walger-lucas/SPARtS/docs/LatexFinal/BunnySuicidesLatex.png

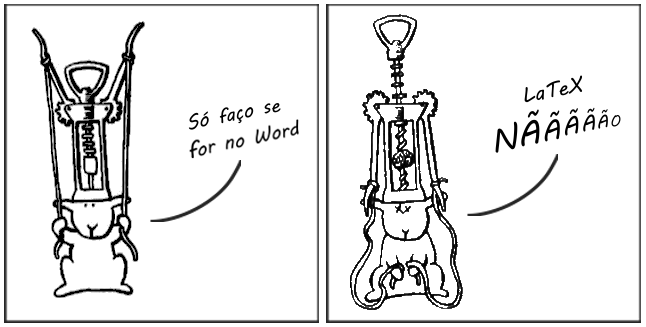
docs/LatexFinal/BunnySuicidesLatex.png
