walger-lucas/SPARtS/docs/LatexFinal/SistNumSeres_base2_3.png

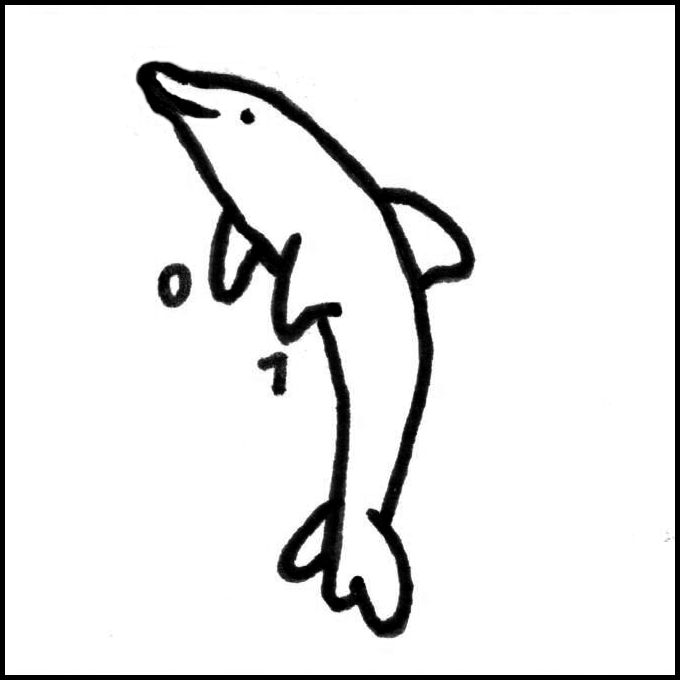
docs/LatexFinal/SistNumSeres_base2_3.png
