walger-lucas/SPARtS/docs/LatexFinal/SistNumSeres_base4_3.png

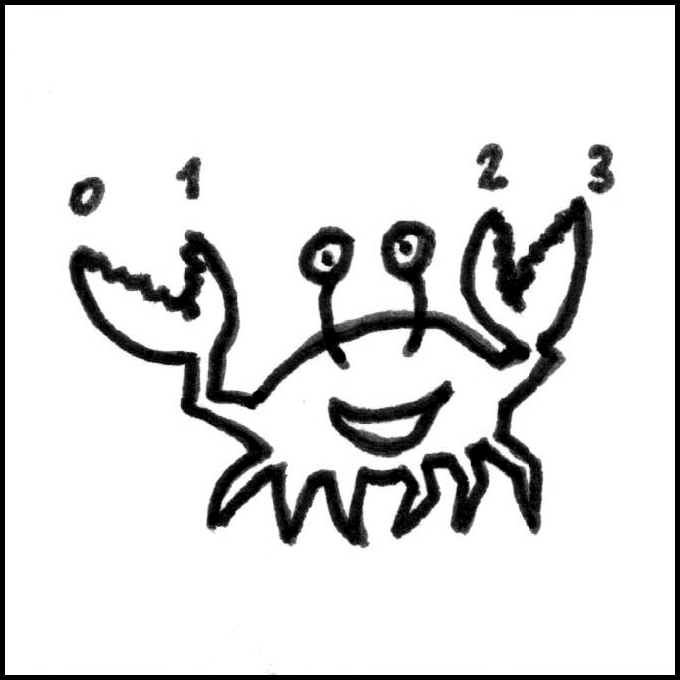
docs/LatexFinal/SistNumSeres_base4_3.png
