walger-lucas/SPARtS/docs/LatexFinal/SistNumSeres_base8_3.png

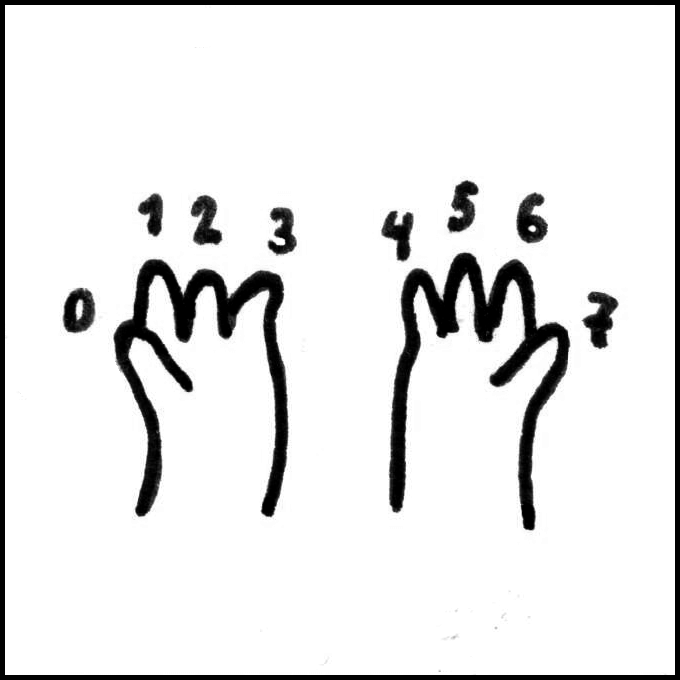
docs/LatexFinal/SistNumSeres_base8_3.png
