walger-lucas/SPARtS/docs/LatexFinal/SistNumSeres_base10_3.png

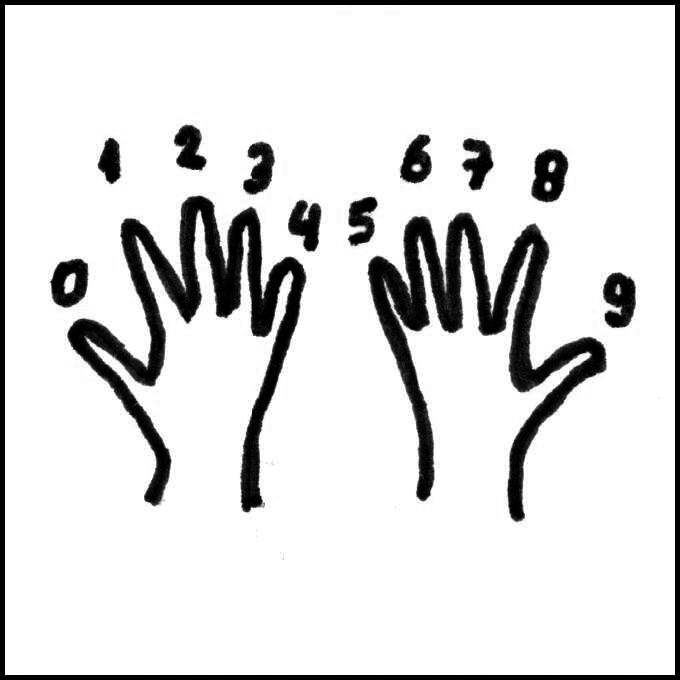
docs/LatexFinal/SistNumSeres_base10_3.png
