walger-lucas/SPARtS/docs/SoftwareDesign/class/class_diagram.png

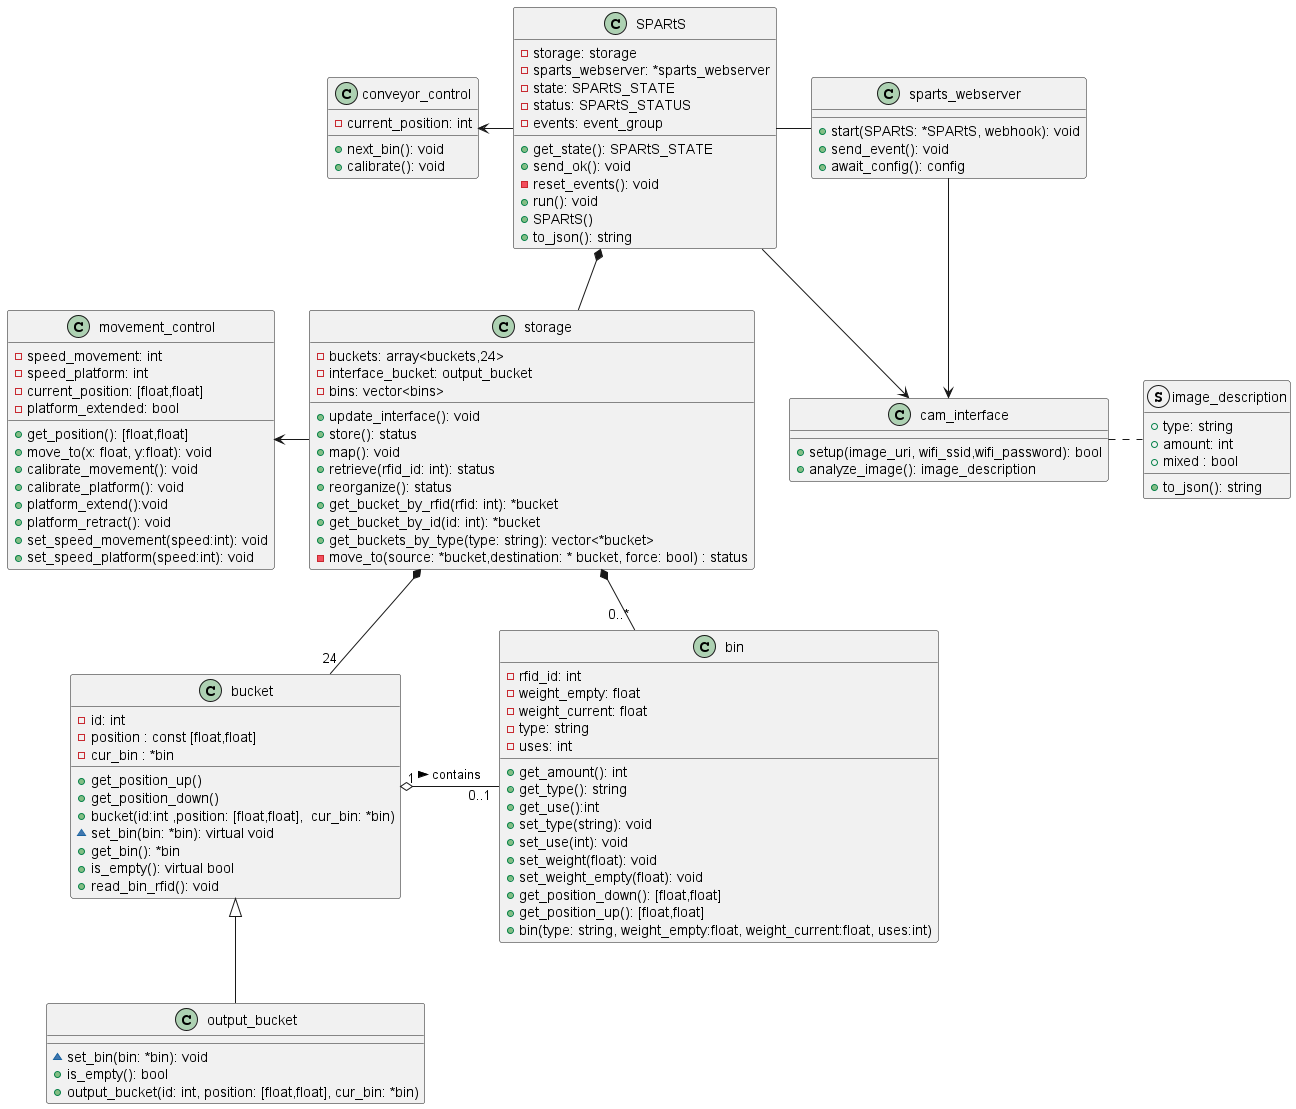
docs/SoftwareDesign/class/class_diagram.png
