walger-lucas/SPARtS/docs/SoftwareDesign/EmbeddedSoftware/output_diagrams/Await.png

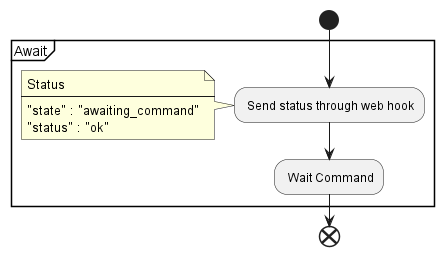
docs/SoftwareDesign/EmbeddedSoftware/output_diagrams/Await.png
