walger-lucas/SPARtS/docs/SoftwareDesign/EmbeddedSoftware/output_diagrams/EspCam.png

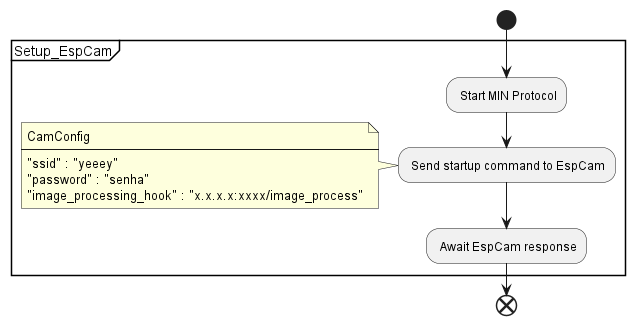
docs/SoftwareDesign/EmbeddedSoftware/output_diagrams/EspCam.png
