walger-lucas/SPARtS/docs/SoftwareDesign/EmbeddedSoftware/output_diagrams/fsm.png

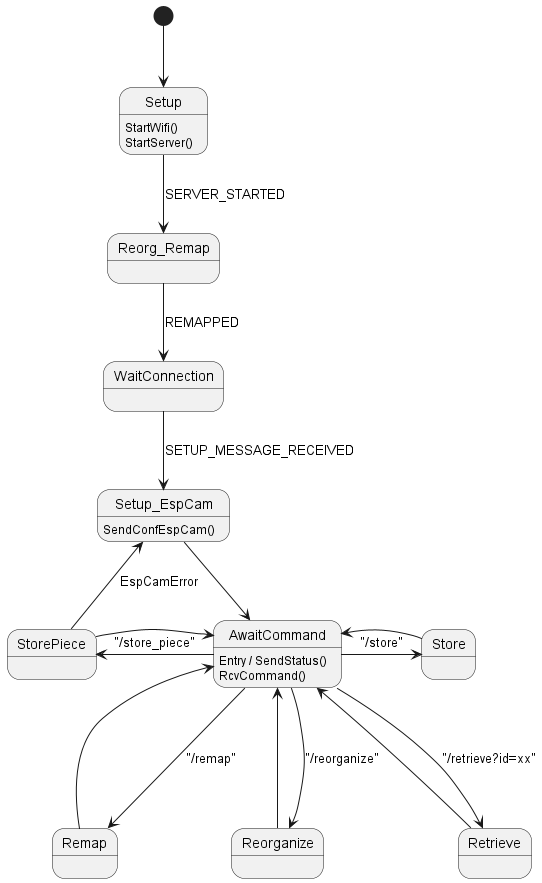
docs/SoftwareDesign/EmbeddedSoftware/output_diagrams/fsm.png
