walger-lucas/SPARtS/docs/SoftwareDesign/EmbeddedSoftware/output_diagrams/remap.png

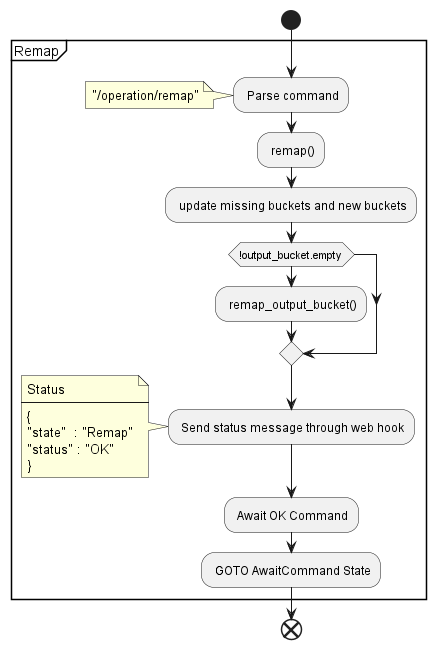
docs/SoftwareDesign/EmbeddedSoftware/output_diagrams/remap.png
