walger-lucas/SPARtS/docs/SoftwareDesign/EmbeddedSoftware/output_diagrams/Reorganize.png

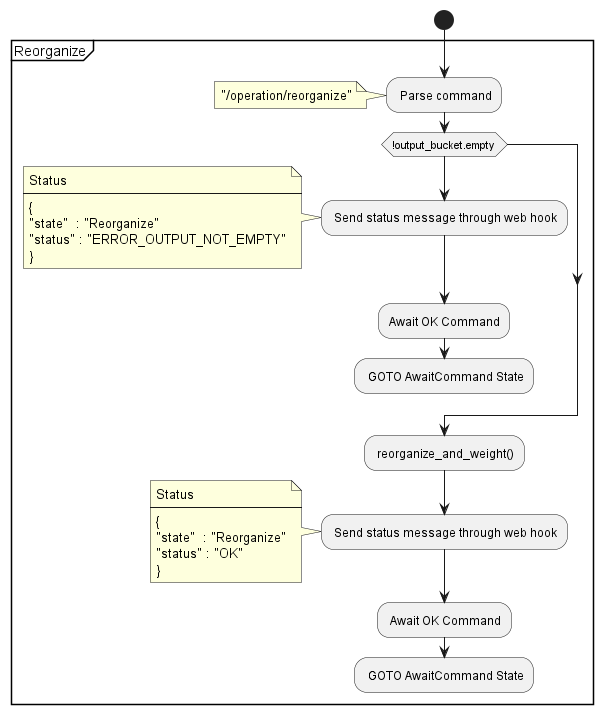
docs/SoftwareDesign/EmbeddedSoftware/output_diagrams/Reorganize.png
