walger-lucas/SPARtS/docs/SoftwareDesign/EmbeddedSoftware/output_diagrams/Retrieve.png

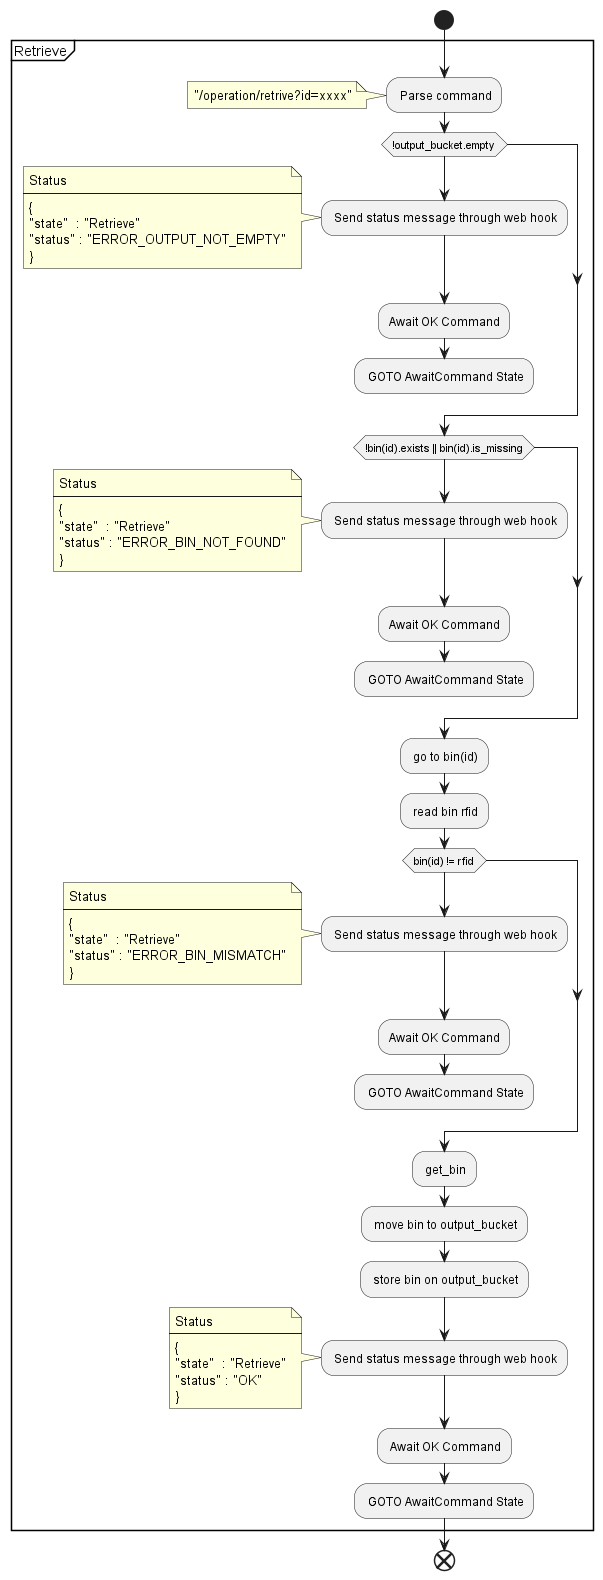
docs/SoftwareDesign/EmbeddedSoftware/output_diagrams/Retrieve.png
