walger-lucas/SPARtS/docs/SoftwareDesign/EmbeddedSoftware/output_diagrams/Store.png

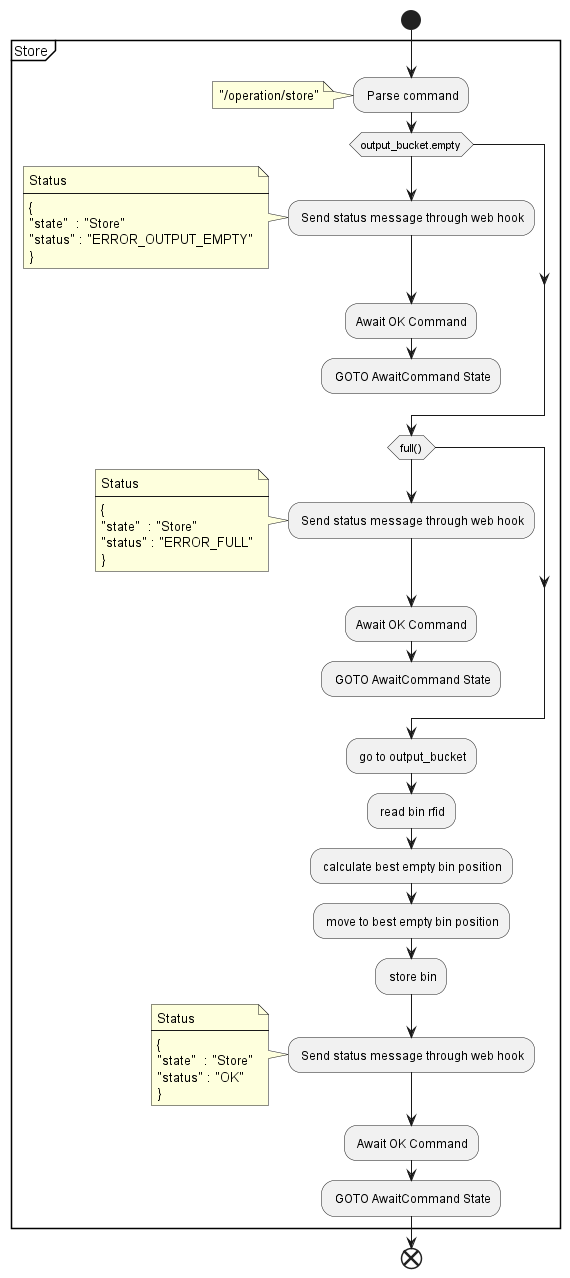
docs/SoftwareDesign/EmbeddedSoftware/output_diagrams/Store.png
