walger-lucas/SPARtS/docs/SoftwareDesign/EmbeddedSoftware/output_diagrams/Store_Piece.png

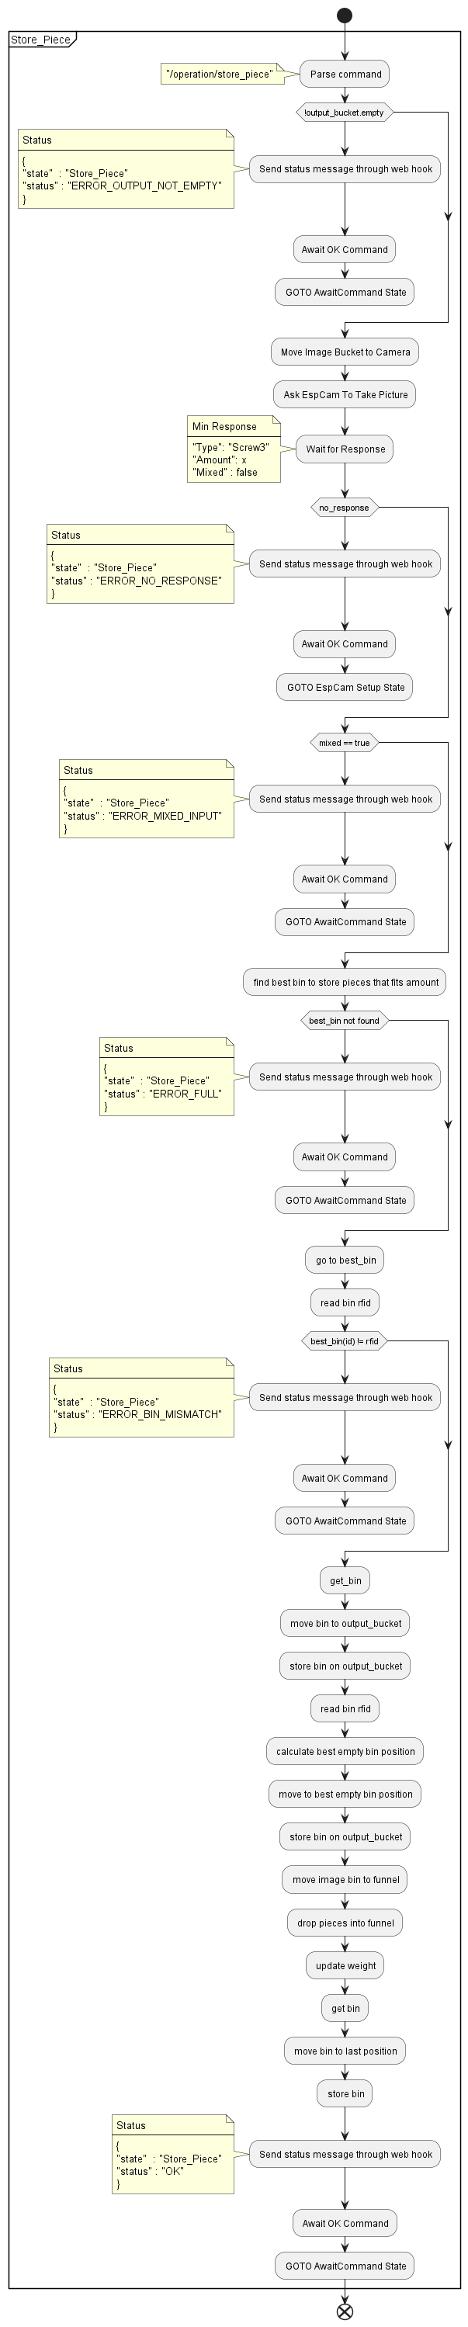
docs/SoftwareDesign/EmbeddedSoftware/output_diagrams/Store_Piece.png
