walger-lucas/SPARtS/docs/SoftwareDesign/flow.png

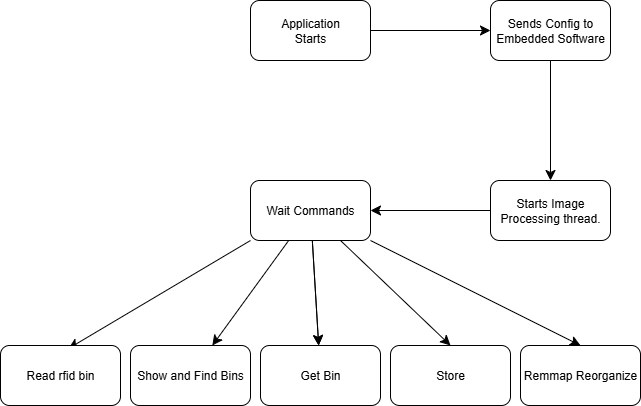
docs/SoftwareDesign/flow.png
