walger-lucas/SPARtS/docs/SoftwareDesign/EmbeddedSoftware/output_diagrams/SETUP.png

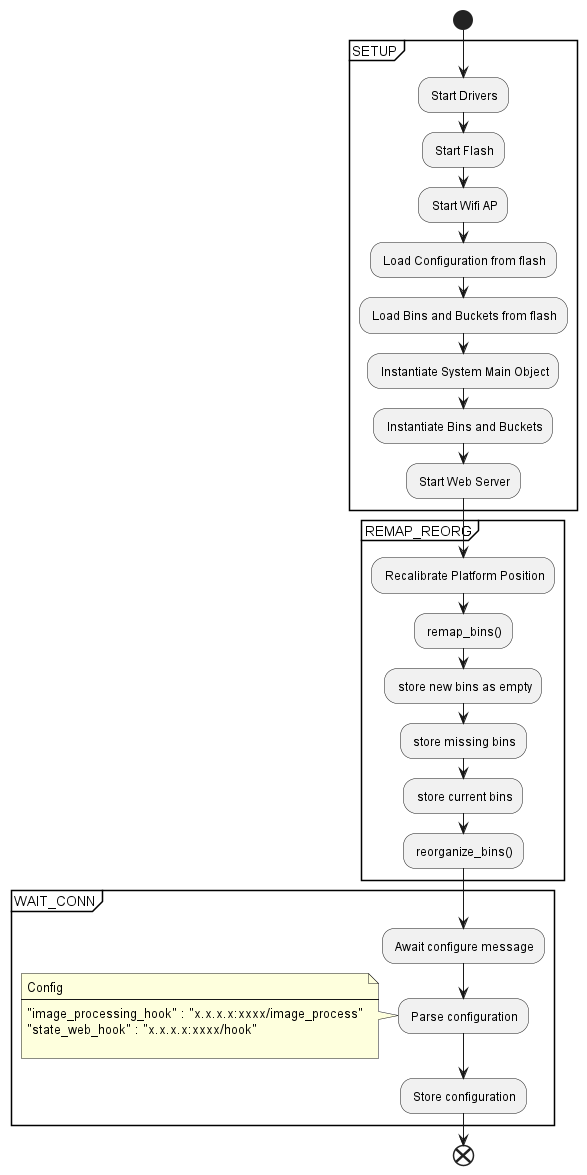
docs/SoftwareDesign/EmbeddedSoftware/output_diagrams/SETUP.png
