walger-lucas/SPARtS/docs/HardwareDesign/SPARtS.pdf

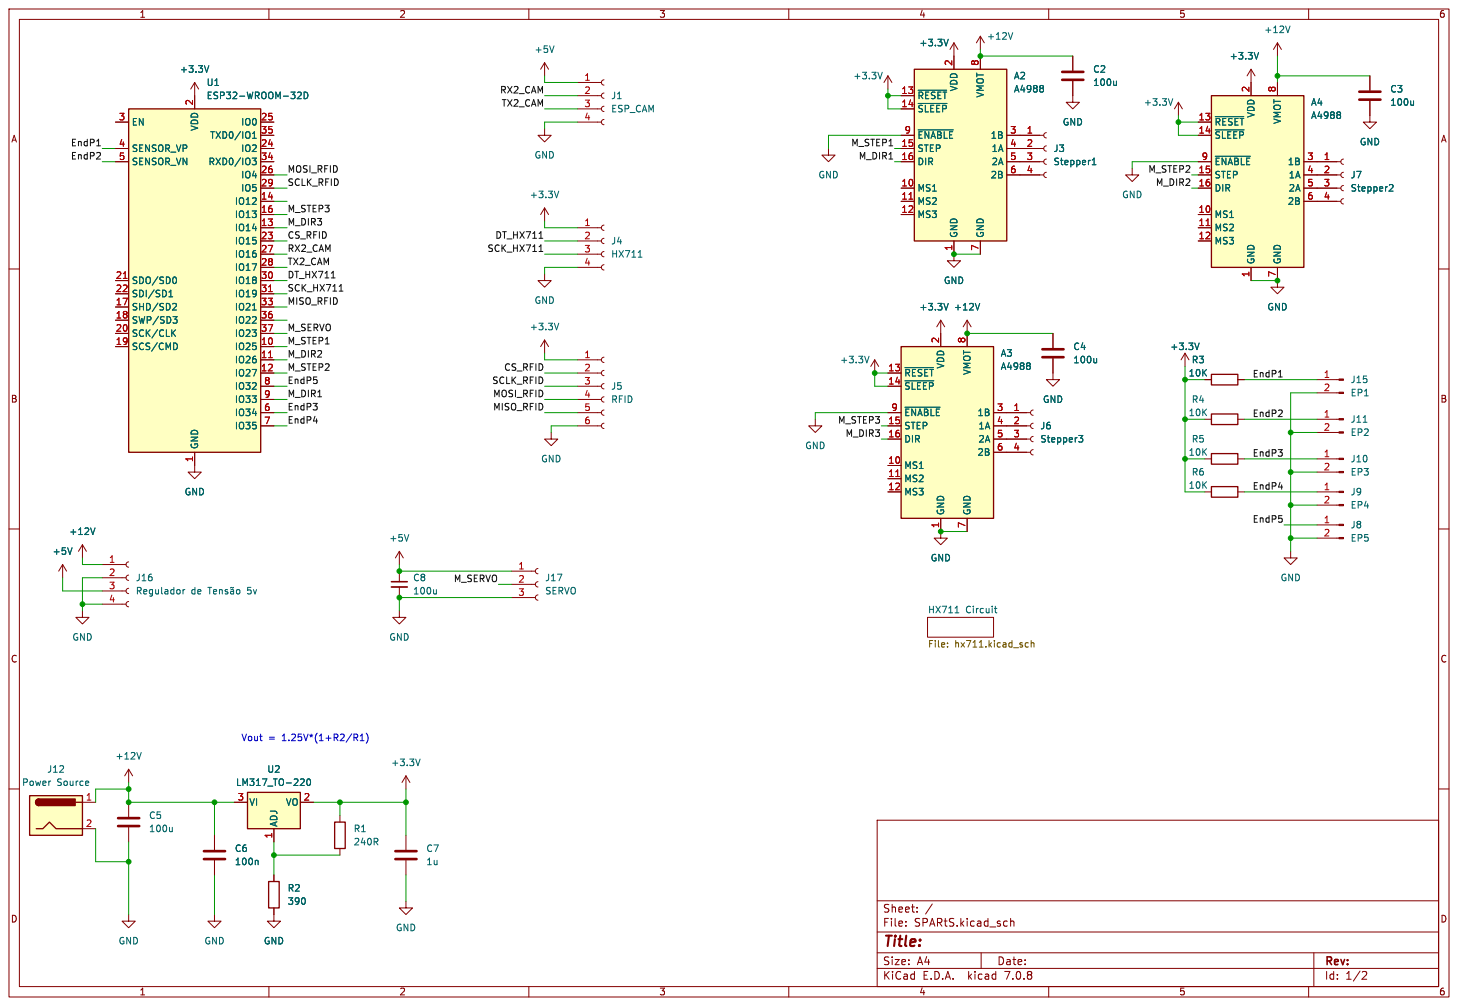
[picture p17: page 1]

1 MS1 10 MS2 11 MS3 12 ~{RESET} 13 ~{SLEEP} 14 STEP 15 DIR 16 VDD

2 SCK/CLK 20 SDO/SD0 21 SDI/SD1 22

Id: 1/2 Title: File: SPARtS.kicad_sch Sheet: /HX711 Circuit File: hx711.kicad_sch
