walger-lucas/SPARtS/docs/HardwareDesign/SPARtS.kicad_sch

## KiCad design docs/HardwareDesign/SPARtS.kicad_sch (2025-11-07)

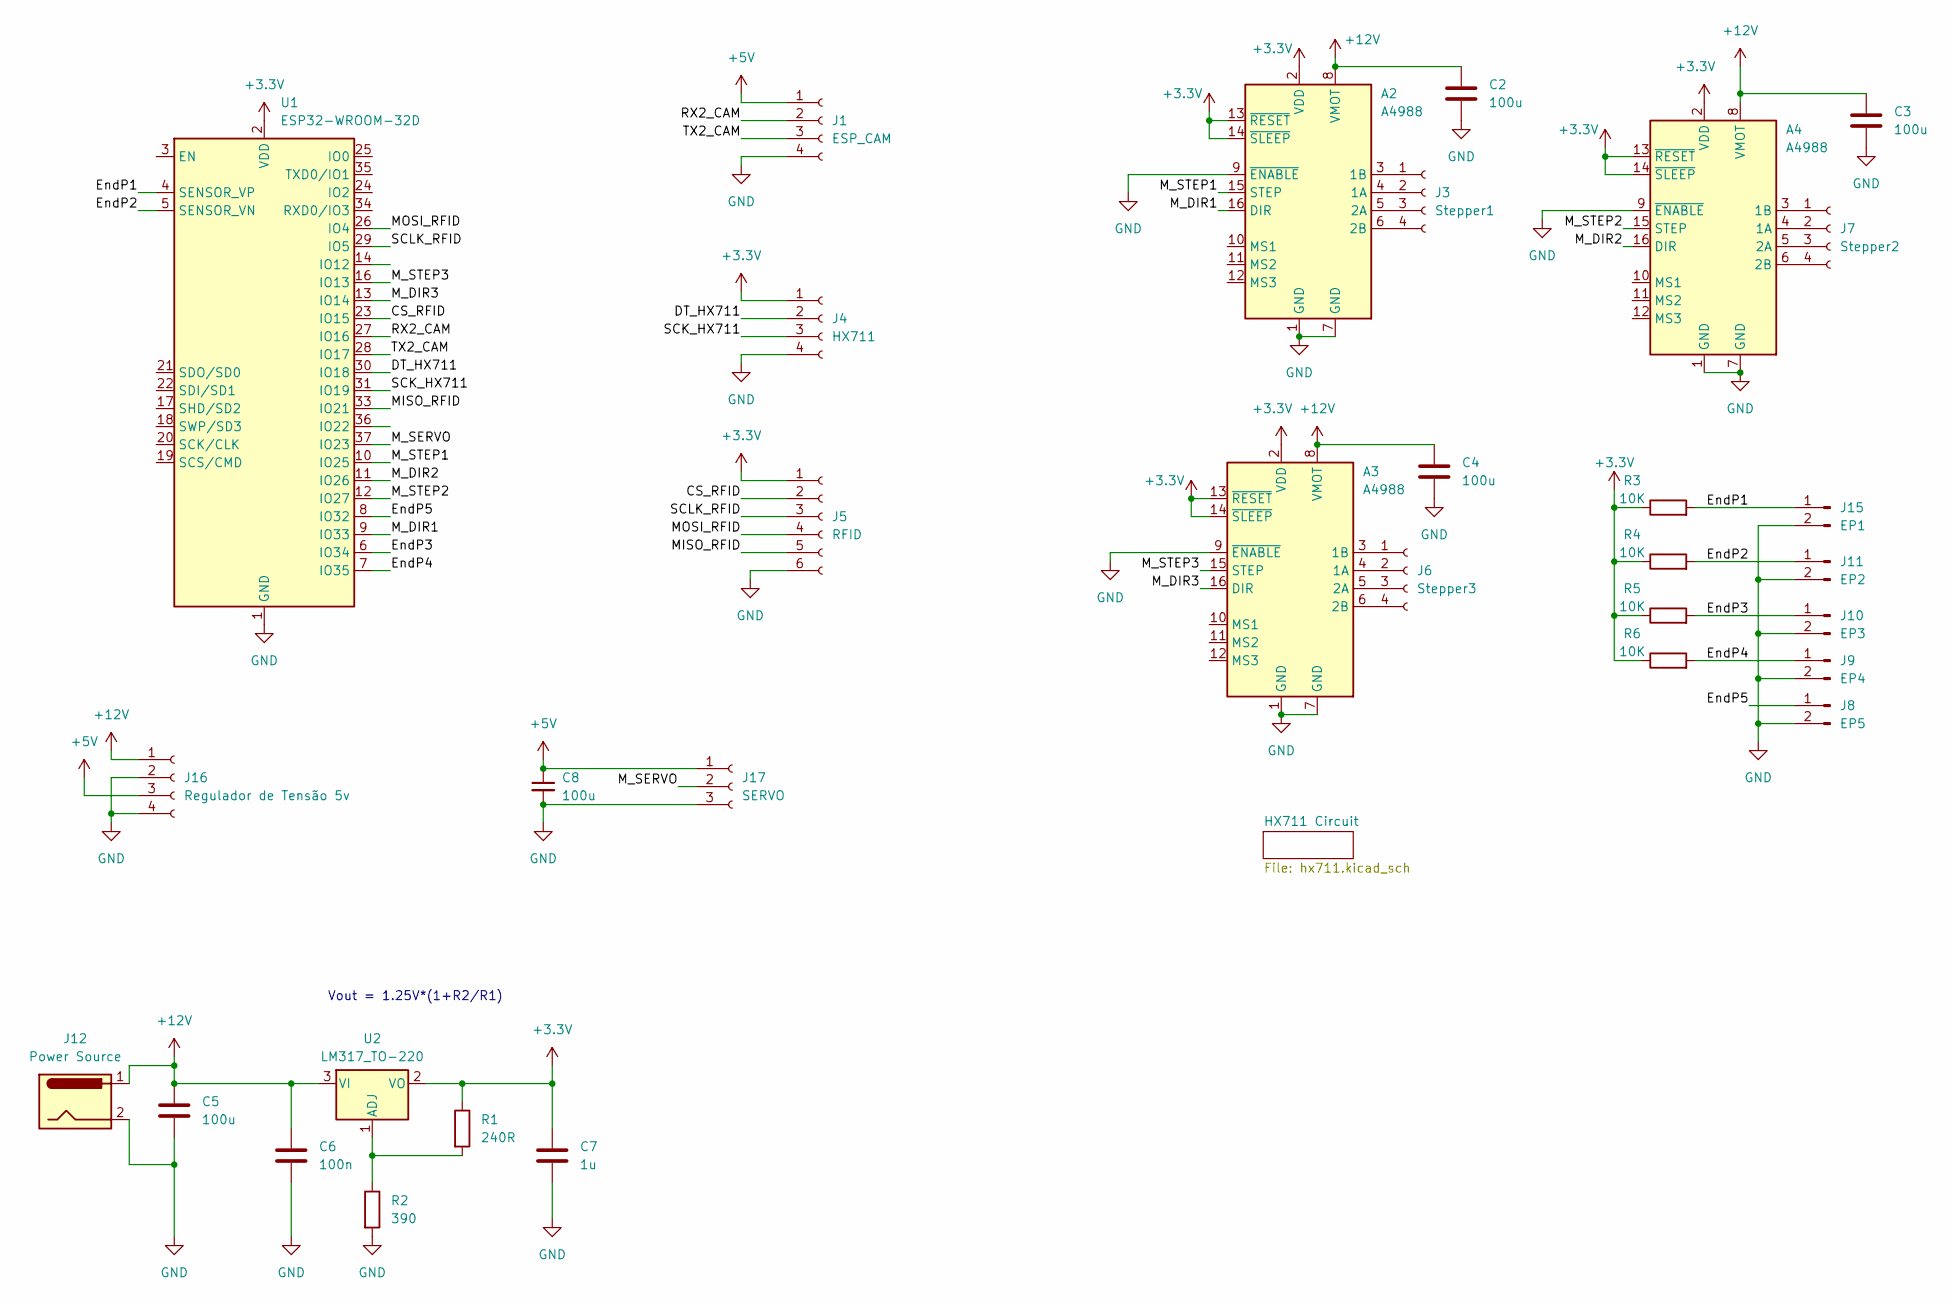
[picture p18: schematic SPARtS.kicad_sch]

Parts:
A2, A3, A4: A4988; Pololu_Breakout-16_15.2x20.3mm
C2, C3, C4, C5, C8: 100u
C6: 100n
C7: 1u
J1: ESP_CAM
J3: Stepper1
J4: HX711
J5: RFID
J6: Stepper3
J7: Stepper2
J8: EP5
J9: EP4
J10: EP3
J11: EP2
J12: Power Source; BarrelJack_SwitchcraftConxall_RAPC10U_Horizontal
J15: EP1
J16: Regulador de Tensão 5v
J17: SERVO
R1: 240R
R2: 390
R3, R4, R5, R6: 10K
U1: ESP32-WROOM-32D
U2: LM317_TO-220; TO-220-3_Vertical

Connections:
+3.3V: A2.2 (VDD), A2.13 (~RESET), A2.14 (~SLEEP), A3.2 (VDD), A3.13 (~RESET), A3.14 (~SLEEP), A4.2 (VDD), A4.13 (~RESET), A4.14 (~SLEEP), C7.1, J4.1, J5.1, R1.1, R3.1, R4.1, R5.1, R6.1, U1.2 (VDD), U2.2 (VO)
+5V: C8.1, J1.1, J16.3, J17.1
+12V: A2.8 (VMOT), A3.8 (VMOT), A4.8 (VMOT), C2.1, C3.1, C4.1, C5.1, C6.1, J12.1, J16.1, U2.3 (VI)
CS_RFID: J5.2, U1.23 (IO15)
DT_HX711: J4.2, U1.30 (IO18)
EndP1: J15.1, R3.2, U1.4 (SENSOR_VP)
EndP2: J11.1, R4.2, U1.5 (SENSOR_VN)
EndP3: J10.1, R5.2, U1.6 (IO34)
EndP4: J9.1, R6.2, U1.7 (IO35)
EndP5: J8.1, U1.8 (IO32)
GND: A2.1 (GND), A2.7 (GND), A2.9 (~ENABLE), A3.1 (GND), A3.7 (GND), A3.9 (~ENABLE), A4.1 (GND), A4.7 (GND), A4.9 (~ENABLE), C2.2, C3.2, C4.2, C5.2, C6.2, C7.2, C8.2, J1.4, J4.4, J5.6, J8.2, J9.2, J10.2, J11.2, J12.2, J15.2, J16.2, J16.4, J17.3, R2.2, U1.1 (GND), U1.15 (GND), U1.38 (GND), U1.39 (GND)
MISO_RFID: J5.5, U1.33 (IO21)
MOSI_RFID: J5.4, U1.26 (IO4)
M_DIR1: A2.16 (DIR), U1.9 (IO33)
M_DIR2: A4.16 (DIR), U1.11 (IO26)
M_DIR3: A3.16 (DIR), U1.13 (IO14)
M_SERVO: J17.2, U1.37 (IO23)
M_STEP1: A2.15 (STEP), U1.10 (IO25)
M_STEP2: A4.15 (STEP), U1.12 (IO27)
M_STEP3: A3.15 (STEP), U1.16 (IO13)
unnamed: A2.3 (1B), J3.1
unnamed: A2.4 (1A), J3.2
unnamed: A2.5 (2A), J3.3
unnamed: A2.6 (2B), J3.4
unnamed: A3.3 (1B), J6.1
unnamed: A3.4 (1A), J6.2
unnamed: A3.5 (2A), J6.3
unnamed: A3.6 (2B), J6.4
unnamed: A4.3 (1B), J7.1
unnamed: A4.4 (1A), J7.2
unnamed: A4.5 (2A), J7.3
unnamed: A4.6 (2B), J7.4
unnamed: R1.2, R2.1, U2.1 (ADJ)
RX2_CAM: J1.2, U1.27 (IO16)
SCK_HX711: J4.3, U1.31 (IO19)
SCLK_RFID: J5.3, U1.29 (IO5)
TX2_CAM: J1.3, U1.28 (IO17)

Notes on the sheet:
Vout = 1.25V*(1+R2/R1)
