walger-lucas/SPARtS/docs/HardwareDesign/hx711.kicad_sch

## KiCad design docs/HardwareDesign/hx711.kicad_sch (2025-09-28)

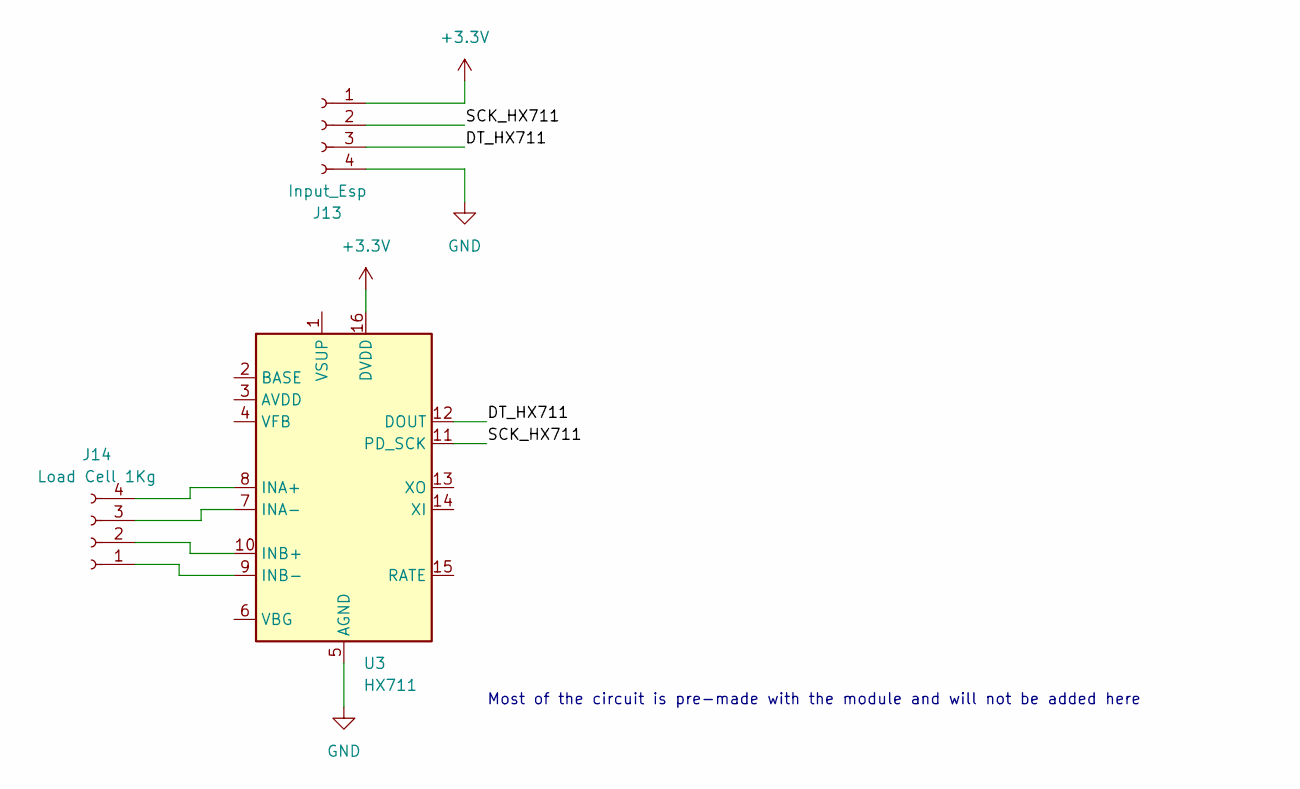
[picture p19: schematic hx711.kicad_sch]

Parts:
J13: Input_Esp
J14: Load Cell 1Kg
U3: HX711; SOP-16_3.9x9.9mm_P1.27mm

Connections:
+3.3V: J13.1, U3.16 (DVDD)
DT_HX711: J13.3, U3.12 (DOUT)
GND: J13.4, U3.5 (AGND)
unnamed: J14.1, U3.9 (INB-)
unnamed: J14.2, U3.10 (INB+)
unnamed: J14.3, U3.7 (INA-)
unnamed: J14.4, U3.8 (INA+)
SCK_HX711: J13.2, U3.11 (PD_SCK)

Notes on the sheet:
Most of the circuit is pre-made with the module and will not be added here
