walger-lucas/SPARtS/(commit log)

2025-09-11 SPARTs main board project created, added common libs
2025-09-13 Kicad project added
    [SPARtS.kicad_pcb, SPARtS.kicad_sch, hx711.kicad_sch, untitled.kicad_sch]
2025-09-28 class diagrams and hardware diagrams
    [hx711.kicad_sch]
2025-10-04 uart cam working
2025-10-12 Changed position of uart protocol
2025-10-19 lots of software done
    [partitions.csv]
2025-10-22 hotfix imagens e conveyor
2025-10-25 dialog de searsh
2025-11-02 filtro por imagem, toasts de aviso e status sendo tratado
2025-11-07 adjustments in dirs, debug with the same imagehandler as app, bash install and run scripts
    [SPARtS.kicad_pcb, SPARtS.kicad_sch, hx711.kicad_sch, partitions.csv, untitled.kicad_sch]
